farukkaradas/Water-level-controller/README.md

# Water-level-controller
Capacitance based DC water level controller with PWM
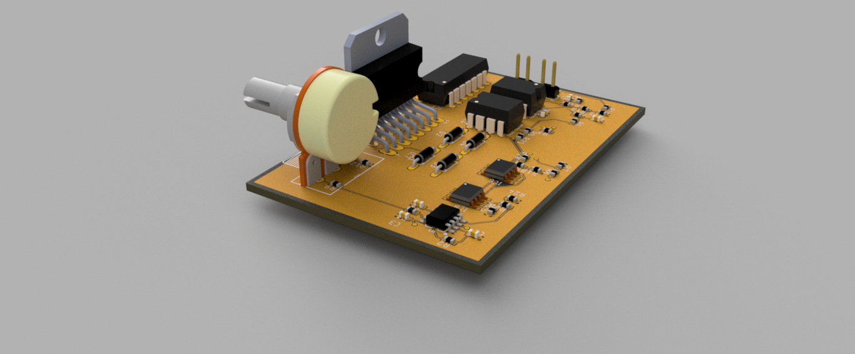
[picture p1: waterlevel v11.png]
3D design
