farukkaradas/Water-level-controller/Water level Controller.asc

A1: xor; Vhigh=5
A2: and; Vhigh=5 Trise=100n Tfall=10n Td=10n
A3: and; Vhigh=5 Trise=100n Tfall=10n Td=10n
A4: diffschmitt; Vhigh=5 Trise=10n Td=10n
A5: diffschmitt; Vt=0 Vh=1m Vhigh=5 Trise=10n Td=10n
C1: cap; 10n; V=25
C2: cap; 10p; V=25
C3: cap; 1µ; V=6.3 Irms=0 Rser=0 Lser=0 mfg="Murata" pn="GRM155R70J105MA12" type="X7R"
C4: cap; 1n
C5: polcap; 100µ; V=25 Irms=370m Rser=0.24 Lser=0 mfg="Nichicon" pn="UPL1E101MPH" type="Al electrolytic"
C6: cap; 100n
C_sensor: cap; 80p
Comp1: diffschmitt; Ref=0 Vhigh=5 Trise=10n Td=20n
D1: schottky; 1N5819
D2: schottky; 1N5819
Lm1: ind; 1m
M1: nmos; FDS4410
M2: nmos; FDS4410
MD1: buf1; Ref=2.5 Vhigh=15 Trise=50n Td=10n
MD2: buf1; Ref=2.5 Vhigh=5 Trise=50n Td=10n
Q1: npn; BC547B
Q2: npn; BC547B
R1: res; 30k; tol=3 pwr=2
R2: res; 470k; tol=3 pwr=2
R3: res; 1k
R4: res; 10k; tol=3
R5: res; 150; tol=1 pwr=0.1
R6: res; 1k
R7: res; 1k; tol=3
R8: res; 1k; tol=3
R9: res; 500; tol=1 pwr=0.1
R10: res; 500; tol=1 pwr=0.1
R11: res; 100K; tol=1 pwr=0.1
R12: res; 1k
R13: res; 100K; tol=1 pwr=0.1
R14: res; 22k
R15: res; 22k
R16: res; 1k
R17: res; 200; tol=1 pwr=0.1
R18: res; 4.75K; tol=1 pwr=0.1
R19: res; 1k; tol=3 pwr=2
R20: res; 100; tol=1 pwr=0.1
R_GND: res; 5.7k; tol=1 pwr=0.1
R_VCC: res; 162K; tol=1 pwr=0.1
Rcs: res; 0.1
RH: res; 1
RL: res; 10K; tol=1 pwr=0.1
Rmotor: res; 4
U1: NE555
U2: LT1001
U4: LT1001
V+: voltage; 5
V-: voltage; -5
Vpwr1: voltage; 10V
XOR: xor; Vhigh=5
Named nets: 0, Clock, trigger, discharge, Digital_Delayed_signal, Delay_signal, Delayed_signal, Dc_signal, V_Error, VCC, V_pot, pot_gnd, pot_vcc, VCC-, tri_in, C1_PosFB, Triangular, Mdrv, G1, G2, Vpwr, Vrcs, nOverC, PWM, 204mv
Oscillator with 555
Obtaining Delay signal
Error Amplifier
Potentiometer
Obtaining DC water level signal
PWM Generation
Triangular wave generation
for 5 cm value of capacitor is 120 pf 
for 15 cm value of capacitor is 250 pf
Enable input
.ic I(Lm)=0
Half Bridge Driver:
Two or more of the drivers in driver IC can be 
used in parallel to increase current output.
Inductive load that 
models motor winding.
Over-current protection:
Voltage on Rcs current-sense 
resistor is compared with the 
threshold set by R18 and R17.
LM311 or LM393 comparator 
with open-collector output
D1 and D2 are required to circulate the 
load current when both of the driver 
transistors are OFF.  Otherwise, voltage 
at Mdrv can be very high due to Lm*di/dt.
.tran 0 0.75m 0.1m uic
Emitter-follower
