farukkaradas/Water-level-controller/waterlevel.brd

## EAGLE design waterlevel.brd (2020-09-01)

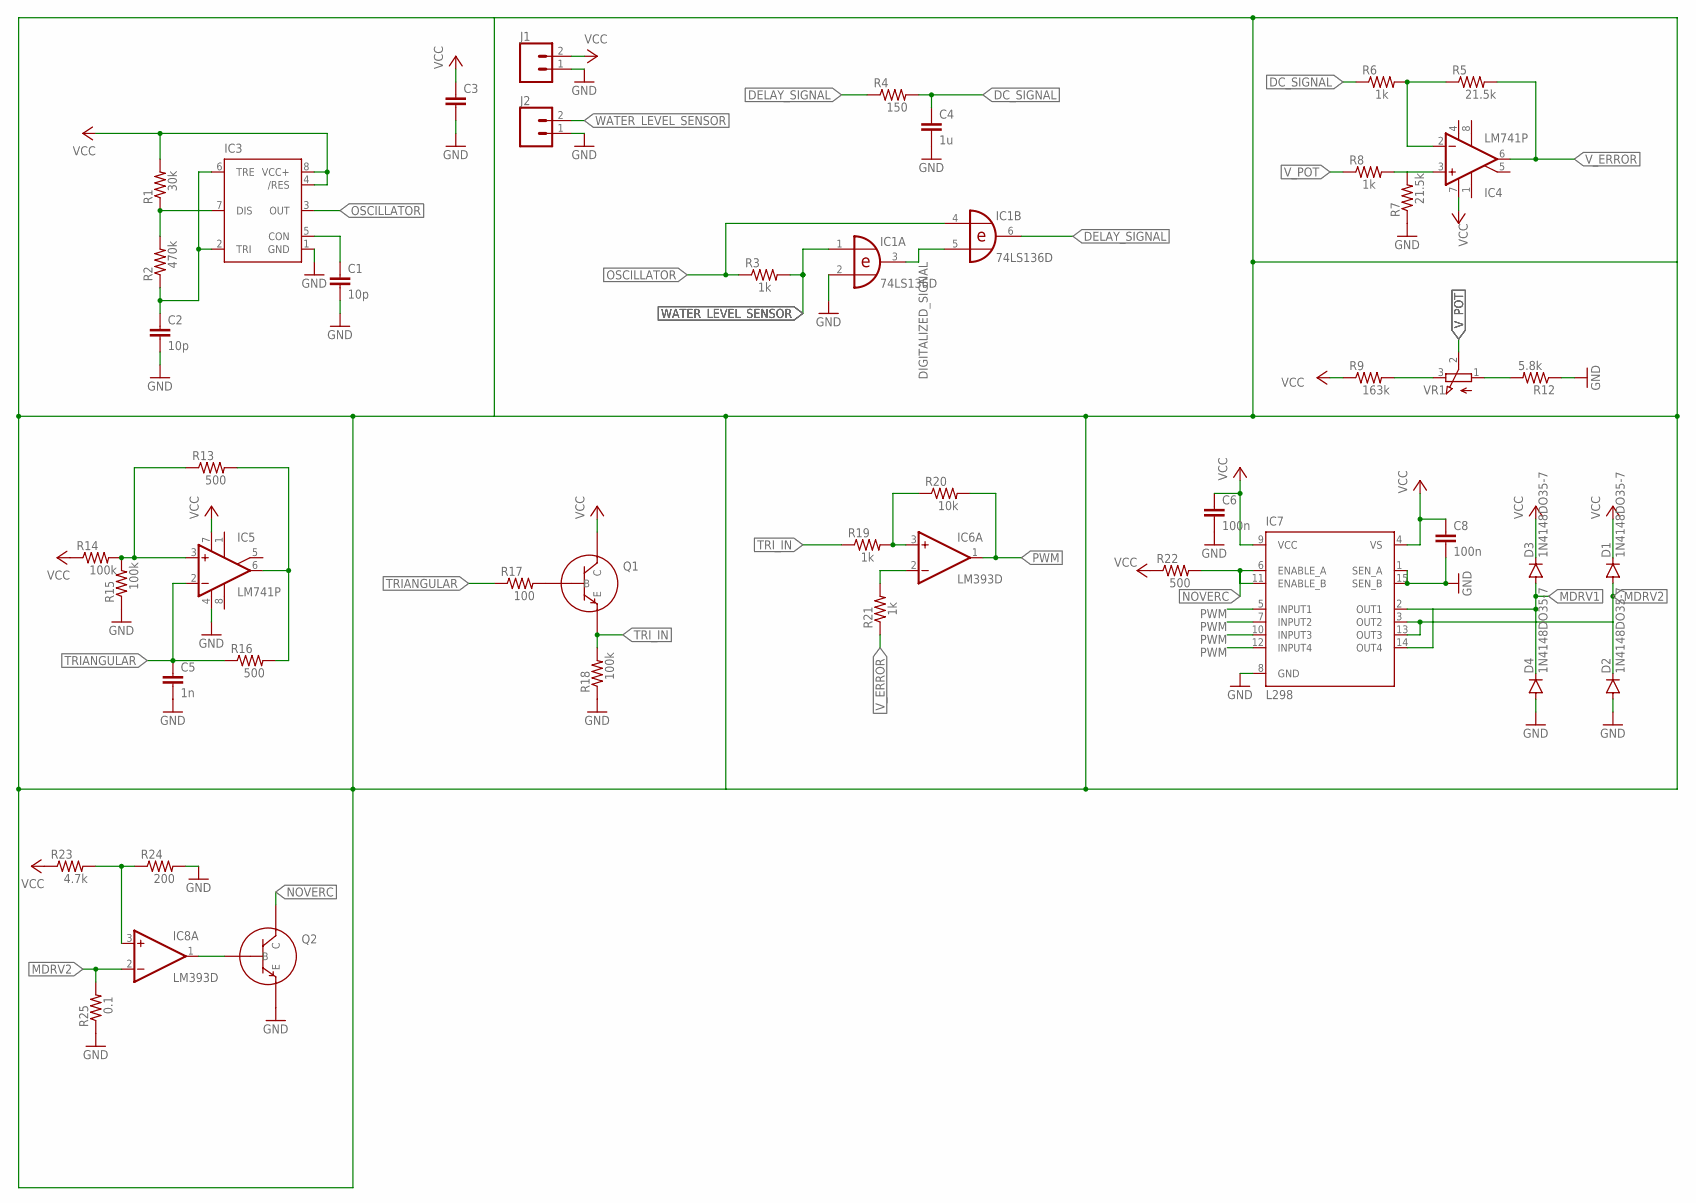
[picture p21: schematic waterlevel.sch]

Parts:
C1, C2: 10p; C0603
C3: C-EUC0603; C0603
C4: 1u; C0603
C5: 1n; C0603
C6, C8: 100n; C0603
D1, D2, D3, D4: 1N4148DO35-7; DO35-7
IC1: 74LS136D; DIL14
IC3: 555; SO08
IC4, IC5: LM741P; DIL08
IC6, IC8: LM393D; SO08
IC7: L298; MULTIWATT-15
J1, J2: CONN_022; 1X02
R1: 30k; R0603
R2: 470k; R0603
R3, R6, R8, R19, R21: 1k; R0603
R4: 150; R0603
R5, R7: 21.5k; R0603
R9: 163k; R0603
R12: 5.8k; R0603
R13, R16, R22: 500; R0603
R14, R15, R18: 100k; R0603
R17: 100; R0603
R20: 10k; R0603
R23: 4.7k; R0603
R24: 200; R0603
R25: 0.1; R0603
VR1: 10k; 3RP/1610N

Connections:
DC_SIGNAL: C4.1, R4.2, R6.1
DELAY_SIGNAL: IC1.6 (O), R4.1
DIGITALIZED_SIGNAL: IC1.3 (O), IC1.5 (I1)
GND: C1.2, C2.2, C3.2, C4.2, C5.2, C6.2, C8.2, D2.A, D4.A, IC1.2 (I1), IC1.7 (GND), IC3.1 (GND), IC5.4 (V-), IC7.1 (SEN_A), IC7.8 (GND), IC7.15 (SEN_B), J1.1, J2.1, R7.1, R12.1, R15.1, R18.1, R24.2, R25.1
MDRV1: D3.A, D4.C, IC7.2 (OUT1), IC7.14 (OUT4)
MDRV2: D1.A, D2.C, IC7.3 (OUT2), IC7.13 (OUT3)
unnamed: IC3.7 (DIS), R1.1, R2.2
unnamed: R9.2, VR1.3 (E)
unnamed: C1.1, IC3.5 (CON)
unnamed: C2.1, IC3.2 (TRI), IC3.6 (TRE), R2.1
unnamed: IC4.2 (-IN), R5.1, R6.2
unnamed: IC4.3 (+IN), R7.2, R8.2
unnamed: IC5.6 (OUT), R13.2, R16.2
unnamed: IC5.3 (+IN), R13.1, R14.2, R15.2
unnamed: IC6.3 (+IN), R19.2, R20.1
unnamed: IC8.3 (+IN), R23.2, R24.1
unnamed: IC6.2 (-IN), R21.2
unnamed: IC8.2 (-IN), R25.2
NOVERC: IC7.6 (ENABLE_A), IC7.11 (ENABLE_B), R22.2
OSCILLATOR: IC1.4 (I0), IC3.3 (OUT), R3.1
PWM: IC6.1 (OUT), IC7.5 (INPUT1), IC7.7 (INPUT2), IC7.10 (INPUT3), IC7.12 (INPUT4), R20.2
TRIANGULAR: C5.1, IC5.2 (-IN), R16.1, R17.1
TRI_IN: R18.2, R19.1
V+: IC6.8 (V+), IC8.8 (V+)
V-: IC4.4 (V-), IC6.4 (V-), IC8.4 (V-)
VCC: C3.1, C6.1, C8.1, D1.C, D3.C, IC1.14 (VCC), IC3.4 (/RES), IC3.8 (VCC+), IC4.7 (V+), IC5.7 (V+), IC7.4 (VS), IC7.9 (VCC), J1.2, R1.2, R9.1, R14.1, R22.1, R23.1
V_ERROR: IC4.6 (OUT), R5.2, R21.1
V_POT: R8.1, R12.2, VR1.1 (A)
WATER_LEVEL_SENSOR: IC1.1 (I0), J2.2, R3.2

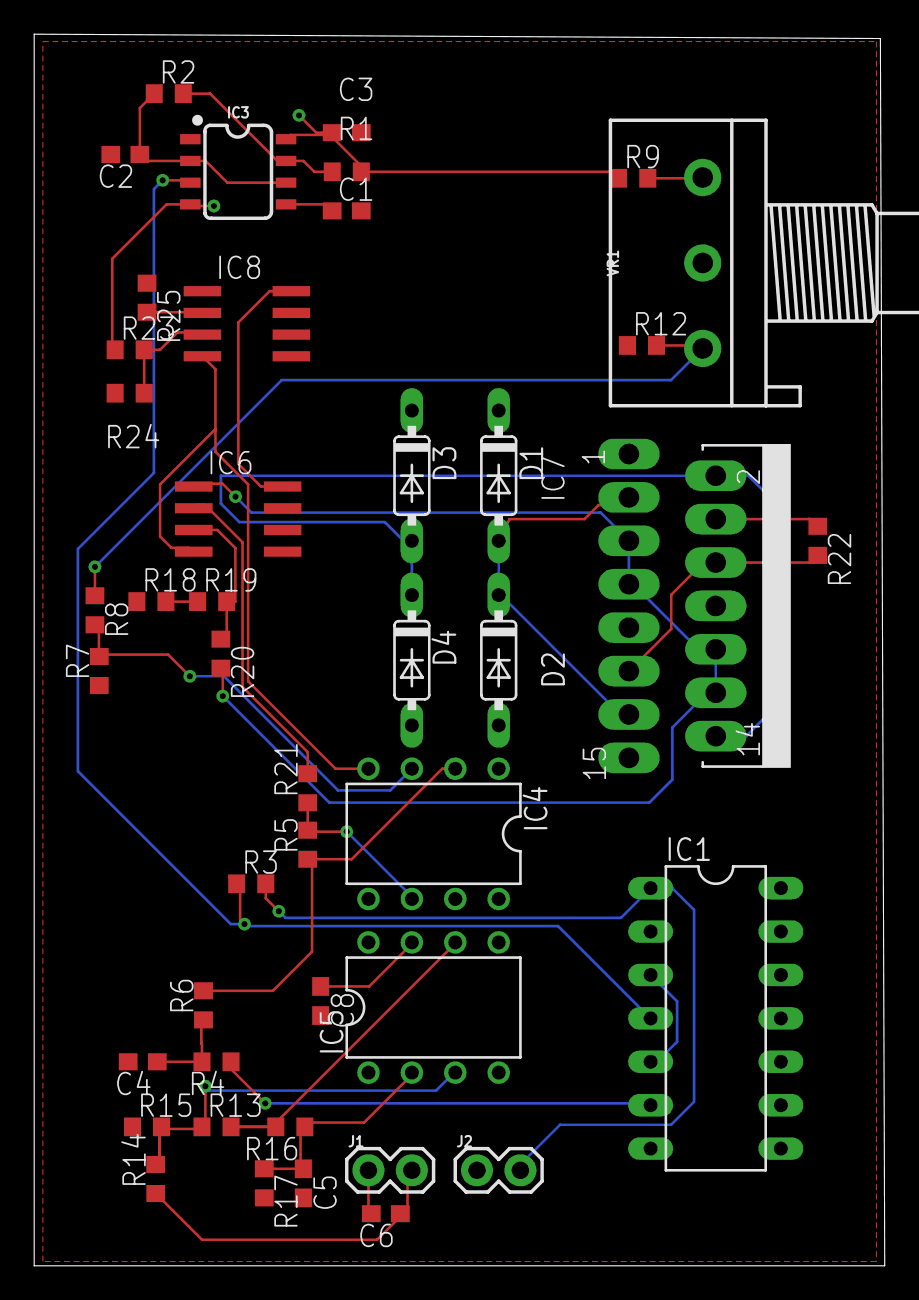
[picture p22: board waterlevel.brd from above]

Board: 2 copper layers, 49.8 x 72.1 mm, 44 parts (0 on the bottom side), 29 nets.
